motine/sternenwecker/box/smallbox.png

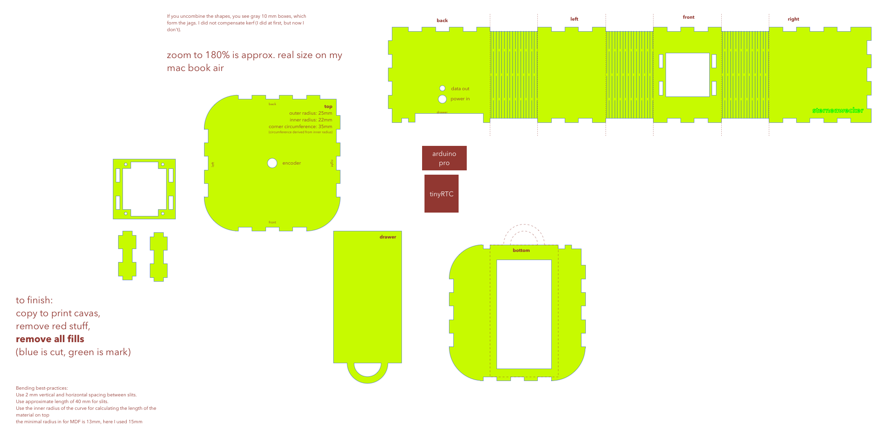
box/smallbox.png
