motine/sternenwecker/concept/brightness-comparison.jpg

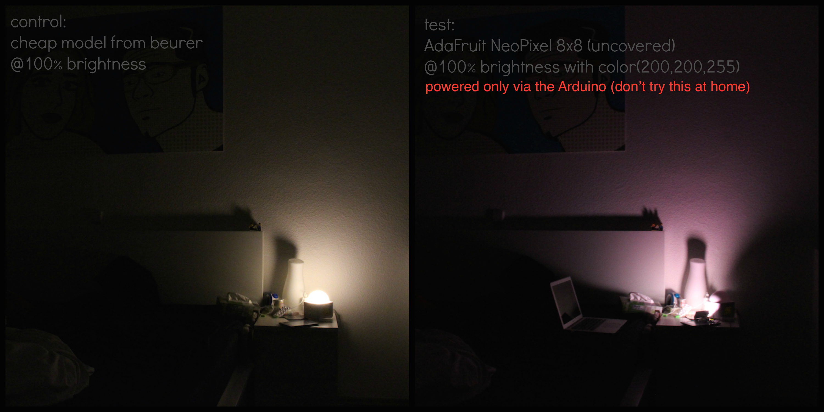
concept/brightness-comparison.jpg
