motine/sternenwecker/concept/digits-1.jpeg

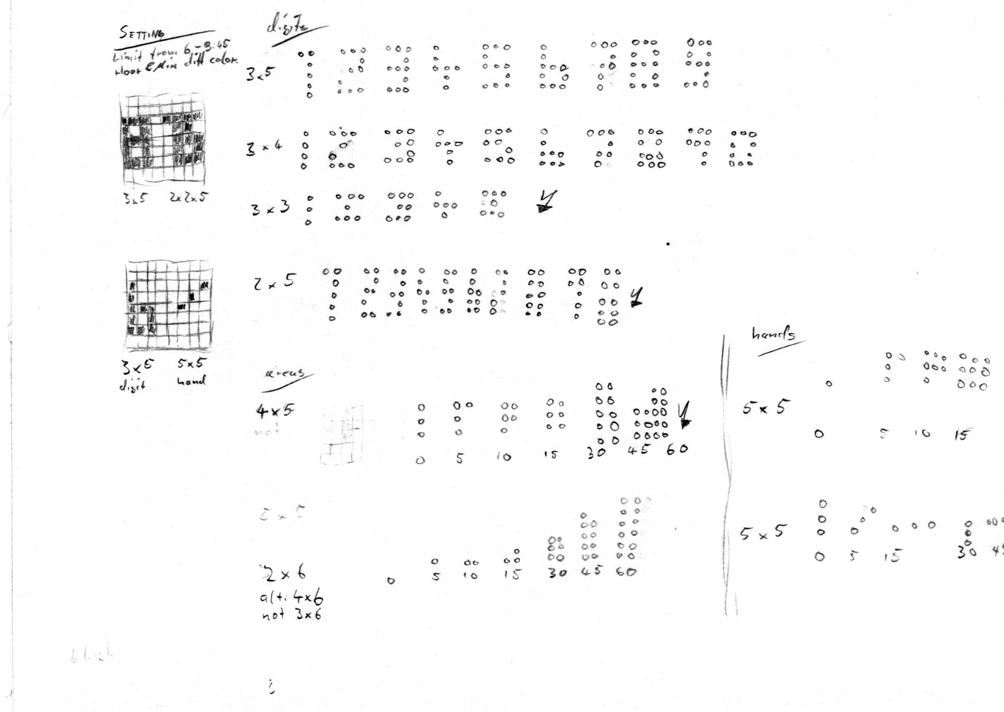
concept/digits-1.jpeg
