motine/sternenwecker/concept/digits-2.jpeg

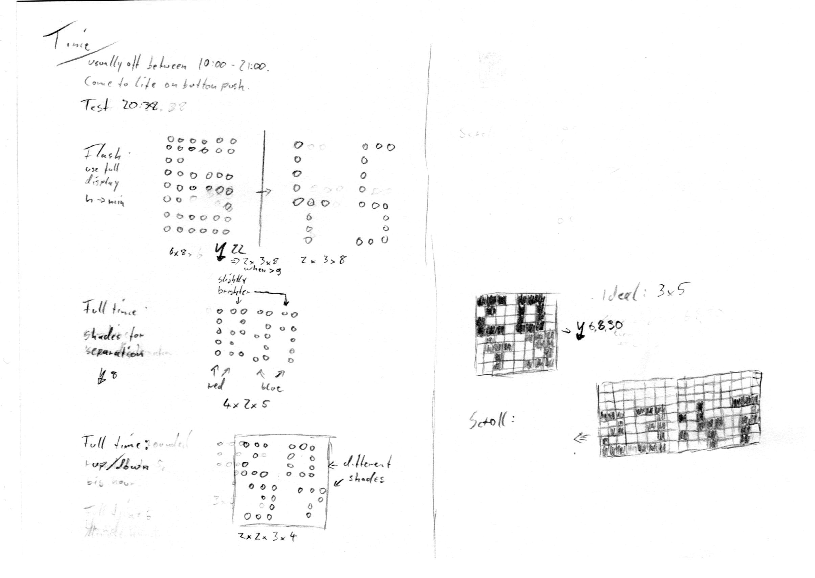
concept/digits-2.jpeg
