motine/sternenwecker/concept/formula-sunrise.jpg

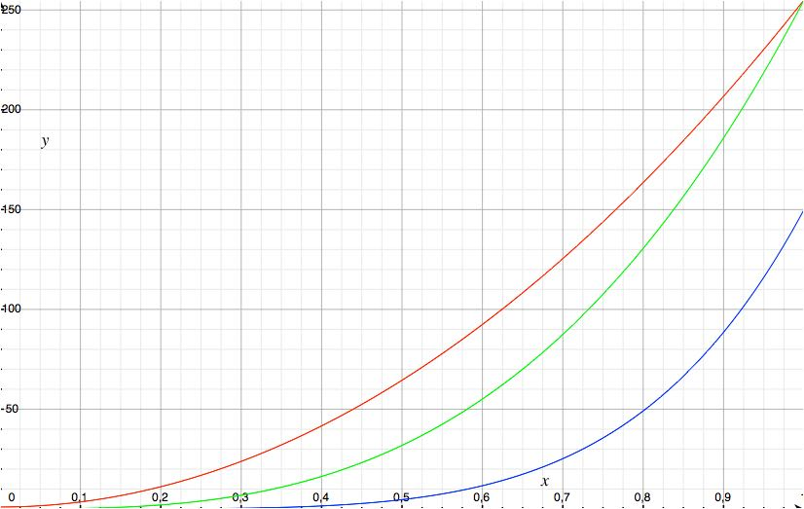
concept/formula-sunrise.jpg
