motine/sternenwecker/concept/acrylic_diffuse_test_in_shop.jpg

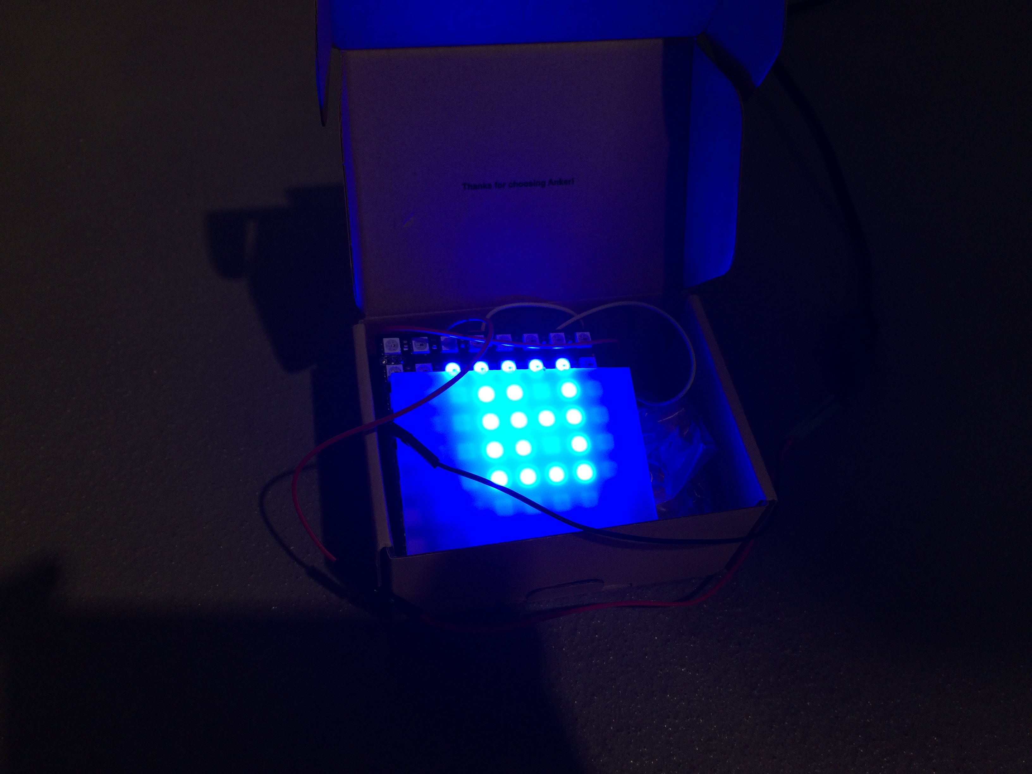
concept/acrylic_diffuse_test_in_shop.jpg
