motine/sternenwecker/sternenwecker/modes.h

#ifndef MODES_H
#define MODES_H

#define TIME_DURATION 2000 // ms

#define IDLE_DELAY 50 // ms, used when the arduino is not supposed to do much (i.e. if it does not need to respond to encoder rotations)
#define MENU_COUNT 4
#define TORCH_AUTO_OFF 5400000UL // ms, turn off after this many milliseconds since torch was activated (prevent overheating)
#define TORCH_HUE_START 8
#define TORCH_HUE_STEPS 80
#define TORCH_BRIGHTNESS_MIN 1
#define TORCH_BRIGHTNESS_START 7
#define TORCH_BRIGHTNESS_STEPS 30
#define MIN_ALARM_HOUR 5 // will start only at 5:00
#define MAX_ALARM_HOUR 23 // will only go to XX:45
#define ALARMING_RISE_DURATION 1800000UL // ms
#define ALARMING_AUTO_OFF 5400000UL // ms, turns the LEDs off after this many milliseconds after the alarm has started (so the LEDs dont get too hot)
#define SUNSET_DURATION  1200000UL // ms
#define SUNSET_TURN_VALUE  30000UL // ms, added/subtracted when the encoder is turned. advances/shifts back the start_millis.
#define CONFIRM_DURATION 1200 // ms

// If a method which returns Mode* is called and it returns something non-NULL, the mode will be set after execution of the method.
class Mode {
  public:
    Mode() {};
    // if loop returns a Mode, the mode will be set by ModeMaster after completing this call.
    virtual Mode* loop() {
      return NULL;
    };
    // called when the sketch initializes
    virtual void init() {};
    // called when the state is entered
    virtual void enter() {};
    // called when the state is left
    virtual void leave() {};
    // called when the encoder button was pressed
    virtual Mode* press() {
      return NULL;
    };
    virtual Mode* longpress() {
      return NULL;
    };
    virtual Mode* button_hold() {
      return NULL;
    };
    // called when the encoder turned clockwise or counter-clockwise
    virtual Mode* left_turn() {
      return NULL;
    };
    virtual Mode* right_turn() {
      return NULL;
    };
  protected:
    void show_time();
};

class MOff : public Mode {
  public:
    MOff() : Mode() { };
    Mode* loop();
    void enter();
    Mode* press();
    Mode* longpress();
};
extern MOff m_off;

class MTime : public Mode {
  public:
    Mode* loop();
    void enter();
    void leave();
    Mode* press();
    Mode* longpress();
  private:
    unsigned long start_millis;
};
extern MTime m_time;

class MMenu : public Mode {
  public:
    MMenu() : Mode() { };
    void enter();
    Mode* press();
    Mode* longpress();
    Mode* left_turn();
    Mode* right_turn();
  private:
    void update();
    uint8_t current;
};
extern MMenu m_menu;

class MTorch : public Mode {
  public:
    void enter();
    Mode* loop();
    Mode* press();
    // longpress may not be used when having button_hold
    Mode* button_hold();
    Mode* left_turn();
    Mode* right_turn();
  private:
    void update();
    uint16_t hue;
    uint8_t brightness;
    unsigned long enter_millis;
};
extern MTorch m_torch;

class MSetTime : public Mode {
  public:
    MSetTime() : Mode() { };
    void enter();
    Mode* loop();
    Mode* press();
    Mode* longpress();
    Mode* left_turn();
    Mode* right_turn();
  private:
    void update();
    uint8_t state;
    uint8_t hour, minute;
};
extern MSetTime m_set_time;

class MSetAlarm : public Mode {
  public:
    MSetAlarm() : Mode() { };
    void enter();
    Mode* press();
    Mode* longpress();
    Mode* left_turn();
    Mode* right_turn();
  private:
    void update();
    void change_alarm(int8_t add);
};
extern MSetAlarm m_set_alarm;

class MAlarming : public Mode {
  public:
    void enter();
    Mode* loop();
    Mode* press();
  private:
    unsigned long start_millis;
};
extern MAlarming m_alarming;

class MSunset : public Mode {
  public:
    void enter();
    Mode* loop();
    Mode* press();
    Mode* left_turn();
    Mode* right_turn();
  private:
    unsigned long start_millis;
};
extern MSunset m_sunset;

class MConfirm : public Mode {
  public:
    MConfirm() : Mode() { };
    void enter();
    Mode* loop();
    Mode* press();
  private:
    unsigned long enter_millis;
};
extern MConfirm m_confirm;

#endif
