motine/sternenwecker/sternenwecker/sternenwecker.ino

#include <Adafruit_NeoPixel.h>
#include "Adafruit_LEDBackpack.h"
#include "Adafruit_GFX.h"
#include <Wire.h>
#include <RTClib.h>
#include "modes.h"
#include "resources.h"

void setup() {
  Serial.begin(9600);
  setup_resources();
}

void loop() {
  loop_resources();
}
