motine/sternenwecker/(commit log)

2015-03-01 Add Arduino shopping link
2015-03-03 circuit info
2015-03-07 more parts for laser cut, added TODOs
2015-03-08 all parts in laser cut complete
2015-03-08 fixed laser cut issue
2015-03-11 fixed box design and cut the first box out of it
2015-03-12 added encoder testing and more readme
2015-03-13 added circuit drawing
2015-03-15 added framework (from four_point_o)
2015-03-15 added modes and fixed button longpress bug
    [alarm_matrix.cpp, alarm_matrix.h, button.cpp, button.h, mode_master.cpp, mode_master.h, modes.cpp, modes.h]
2015-03-15 added encoder class
2015-03-19 added menu, button hold, torch mode
2015-03-29 fixed hour bug, onboard led off, increased alarm range
    [clock.cpp, modes.cpp, modes.h, resources.cpp]
2015-03-31 added tiny RTC to circuit
2015-03-31 minor changes to circuit and readme
2015-04-02 fixed disabled encoder during sunset
    [modes.cpp, modes.h]
2015-04-07 changed parts for bed version
2015-04-12 added wiring for usb-serial cable
2015-04-17 changed circuit
2015-05-06 added soldering photos
2015-07-29 fixed matrix display methods
    [alarm_matrix.cpp, alarm_matrix.h, resources.cpp]
2015-07-29 adjusted button behavior in modes
2015-07-30 added indenter; fixed code style
    [alarm_clock.cpp, alarm_matrix.cpp, alarm_matrix.h, alarm_strip.cpp, button.cpp, mode_master.cpp, mode_master.h, modes.cpp]
